Vibhors-Tech-Hub/STM32F407-Dev-Kit/production/BOM.csv

Reference Designators (RefDes) | Footprint | Description | Manufacturer Part Number (MPN) | Quantity (per PCB) | Quantity (including spares) | Price (in given quantity)
C1, C3, C4, C5, C6, C14, C18, C22, C23, C24, C26, C28, C29, C30, C34, C35, C38, C40, C41, C43, C45, C50, C55, C56, C57, C58, C60, C62, C63, C65, C67, C68, C69, C73, C76, C80, C81, C84, C85 | 0805 | 100n | 885012207016 | 39 | 43 | $1.80
C2, C54 | 0805 | 4.7u | CL21A475KPFNNNF | 2 | 5 | $0.55
C7, C15, C19, C31, C32, C33 | 0805 | 10n | 885012207011 | 6 | 9 | $0.59
C8, C13, C17, C25, C37, C39, C42, C44, C47, C52, C64, C66 | 0805 | 1u | CL21B105KPFNNNG | 12 | 15 | $0.83
C9, C10, C20, C21, C70, C71 | 0805 | 22p | 885012007002 | 6 | 8 | $0.57
C11 | 0805 | 2n | C0805C202G8HACTU | 1 | 2 | $0.42
C12, C16, C36, C46, C72, C82, C86 | 0805 | 10u | GRM21BR71A106KA73K | 7 | 9 | $0.70
C27, C75 | 1210 | 100u | EMK325ABJ107MM-P | 2 | 3 | $6.53
C48, C49 | 0805 | 150p | 885012007058 | 2 | 3 | $0.33
C51, C53 | 0805 | 22n | CL21B223JBANNNC | 2 | 3 | $0.30
C59, C61 | 0805 | 2.2u | 0805B225K250CT | 2 | 3 | $0.39
C74 | 10*12.5 | 1000u | A768MS108M1CLAE015 | 1 | 2 | $2.34
C77, C79 | 0805 | 22u | CL21A226KQCLRNC | 2 | 3 | $0.51
C78 | 0805 | 47u | GRM21BR60J476ME01L | 1 | 2 | $0.60
C83 | 1812 | 10n 2kV | C1812X103K202T | 1 | 2 | $2.14
D1, D2 | 0805 | RED | LS R976-NR-1-0-20-R18 | 2 | 3 | $0.54
D3, D4, D5, D6 | D_SOD-923 | ESD3V3D9-TP | ESD3V3D9-TP | 4 | 6 | $1.98
FB1 | 0603 | MPZ1608S331A | MPZ1608S331A | 1 | 2 | $0.20
FB2, FB3, FB4 | 0805 | BLM21PG102SN1D | BLM21PG102SN1D | 3 | 5 | $0.90
J1, J8 | USB_Mini-B_Wuerth_65100516121_Horizontal | GMSB0531112YEU | GMSB0531112YEU | 2 | 5 | $2.86
J2 | PinHeader_1x06_P2.54mm_Vertical | Conn_01x06 |  | 1 | 0 | $0
J3 | RJMG1S8008101BR | RJMG1S8008101BR | RJMG1S8008101BR | 1 | 1 | $2.00
J4 | JST_XH_B2B-XH-A_1x02_P2.50mm_Vertical | B2B-XH-A(LF)(SN) | B2B-XH-A(LF)(SN) | 1 | 2 | $19.02
J5, J9, J10 | PinHeader_1x04_P2.54mm_Vertical | Conn_01x04 |  | 3 | 0 | $0
J7 | SJ-3524-SMT | SJ-3524-SMT | SJ-3524-SMT | 1 | 3 | $3.07
J11 | TBC 2.54mm | TBC 2.54mm 10A | 397730003 | 1 | 2 | $7.11
J12 | IMP34DT05TR | IMP34DT05TR | IMP34DT05TR | 1 | 5 | $16.78
L1 | 0805 | 4.7u | AOTA-N201210S-4R7MT | 1 | 2 | $0.60
R1, R7, R8, R9, R10, R14, R15, R23 | 0805 | 10k | RNCP0805FTD10K0 | 8 | 10 | $0.14
R2 | 0805 | 100r | RC0805FR-07100RL | 1 | 2 | $0.20
R3 | 0805 | 1.5k | RC0805FR-071K5L | 1 | 2 | $0.20
R4 | 0805 | 6.49k 1% | RK73H2ATTD6491F | 1 | 2 | $19.02
R5, R6, R12 | 0805 | 3.3k | RC0805FR-073K3L | 3 | 5 | $0.34
R11, R24, R25 | 0805 | 2k | RK73H2ATTD2001F | 3 | 4 | $0.34
R13 | 0805 | 33k | ERJ-6GEYJ333V | 1 | 2 | $0.20
R16 | 0805 | 50m | RL1220T-R050-G | 1 | 2 | $0.20
R17 | 0805 | 10k | RK73H2ATTD1002F | 1 | 2 | $0.20
R18, R19, R20 | 0805 | 1K | CRCW08051K00FKEA | 3 | 5 | $0.44
R21, R22 | 0805 | 51.1R | RMCF0805FT51R1 | 2 | 3 | $0.27
R26 | 0805 | 1M | SG73P2ATTD1004F | 1 | 2 | $0.30
SW1, SW2, SW3 | SW Push SPST NO Alps SKRK | SW TACT-SPST | SKRKAEE020 | 3 | 4 | $1.64
U1 | LQFP-48_7x7mm_P0.5mm | STM32F103CBT6 | STM32F103CBT6 | 1 | 2 | $21.19
U2 | DP83826IRHBR | DP83826IRHBR | DP83826IRHBR | 1 | 7 | $23.29
U3 | QFN-24-1EP_4x4mm_P0.5mm_EP2.7x2.7mm | DRV8701ERGET | DRV8701ERGET | 1 | 7 | $20.55
U4 | V-DFN5045-12 | DMHT6016LFJ-13 | DMHT6016LFJ-13 | 1 | 3 | $6.28
U5 | TSSOP-16_4.4x5mm_P0.65mm | ADS122C04IPW | ADS122C04IPW | 1 | 2 | $25.41
U6 | VQFN-40-1EP_6x6mm_P0.5mm_EP3.5x3.5mm | CS43L22 | CS43L22 | 1 | 0 | $0
U7 | LQFP-100_14x14mm_P0.5mm | STM32F407VGT6 | STM32F407VGT6 | 1 | 2 | $33.27
U8 | TSOT-23-6 | AP63203WU | AP63203WU | 1 | 3 | $350.97
U9 | SOT-23-3 | XC6206P182MR | XC6206P182MR | 1 | 3 | $28.53
Y1, Y3 | 3225 | ABM8G-8.000MHZ-18-D2Y-T | ECS-80-12-33-JGN-TR3 | 2 | 4 | $2.45
Y2 | 3225 | ABM8G-25.000MHZ-9-B4Y-T | ABM8G-25.000MHZ-9-B4Y-T | 1 | 3 | $2.13
Total: |  |  |  |  |  | $198.13
