Vibhors-Tech-Hub/STM32F407-Dev-Kit/3D/STM32F407 Dev Kit.step

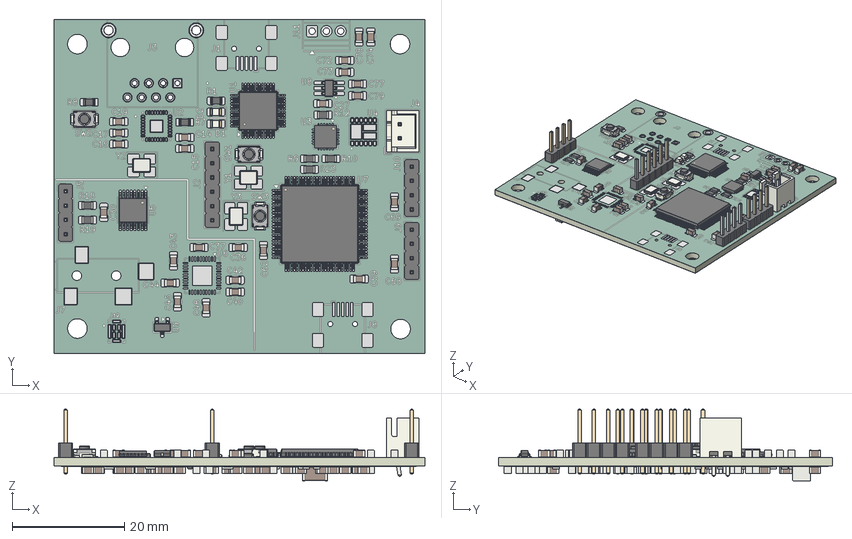
[picture p1: CAD file, 2026-10-30]
3D/STM32F407 Dev Kit.step
66.0 x 59.3 x 12.7 mm
C_0805_2012Metric x 88
LQFP-100_14x14mm_P0.5mm
R_0805_2012Metric x 26
LQFP-48_7x7mm_P0.5mm
JST_B2B_XH_A
SW_Push_SPST_NO_Alps_SKRK x 3
Crystal_SMD_3225-4Pin_3.2x2.5mm x 3
QFN-24-1EP_4x4mm_P0.5mm_EP2.7x2.7mm
PinHeader_1x04_P254mm_Vertical x 3
LED_0805_2012Metric x 2
PinHeader_1x06_P254mm_Vertical
TSOT-23-6
SOT-23-3
TSSOP-16_4.4x5mm_P0.65mm
C_0603_1608Metric
C_1812_4532Metric
D_SOD_923 x 4
L_0805_2012Metric
STM3A46_copper
STM3A46_pad
STM3A46_via
STM3A46_silkscreen x 2
STM3A46_soldermask x 2
STM3A46_PCB
