Vibhors-Tech-Hub/STM32F407-Dev-Kit/hardware/STM32F407 Dev Kit.kicad_pcb

## KiCad design hardware/STM32F407 Dev Kit.kicad_pcb (2026-11-01)

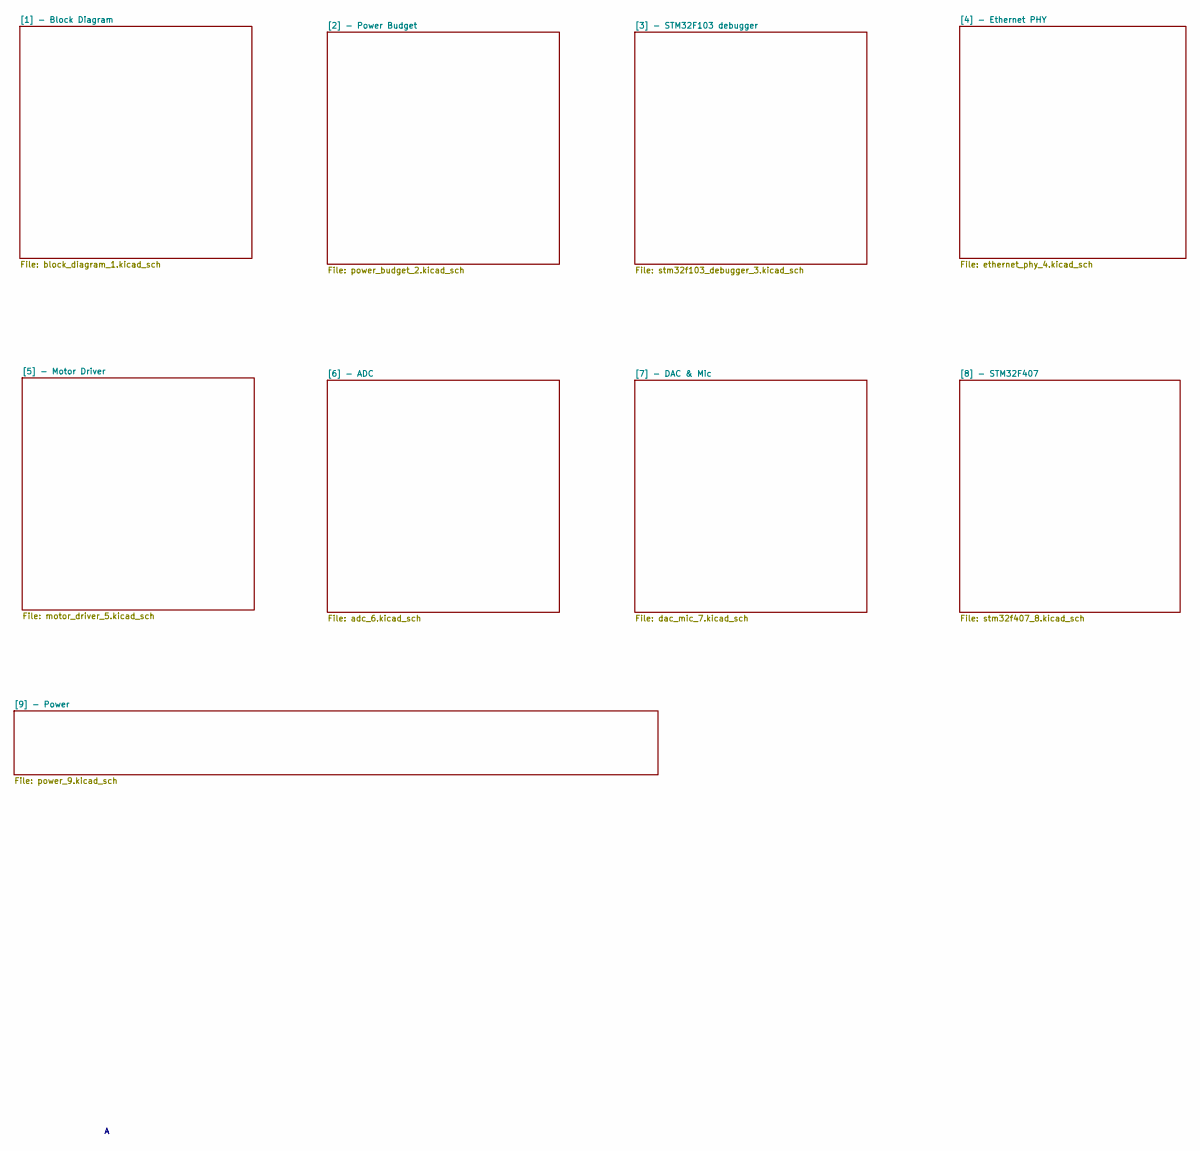
[picture p2: schematic STM32F407 Dev Kit.kicad_sch]

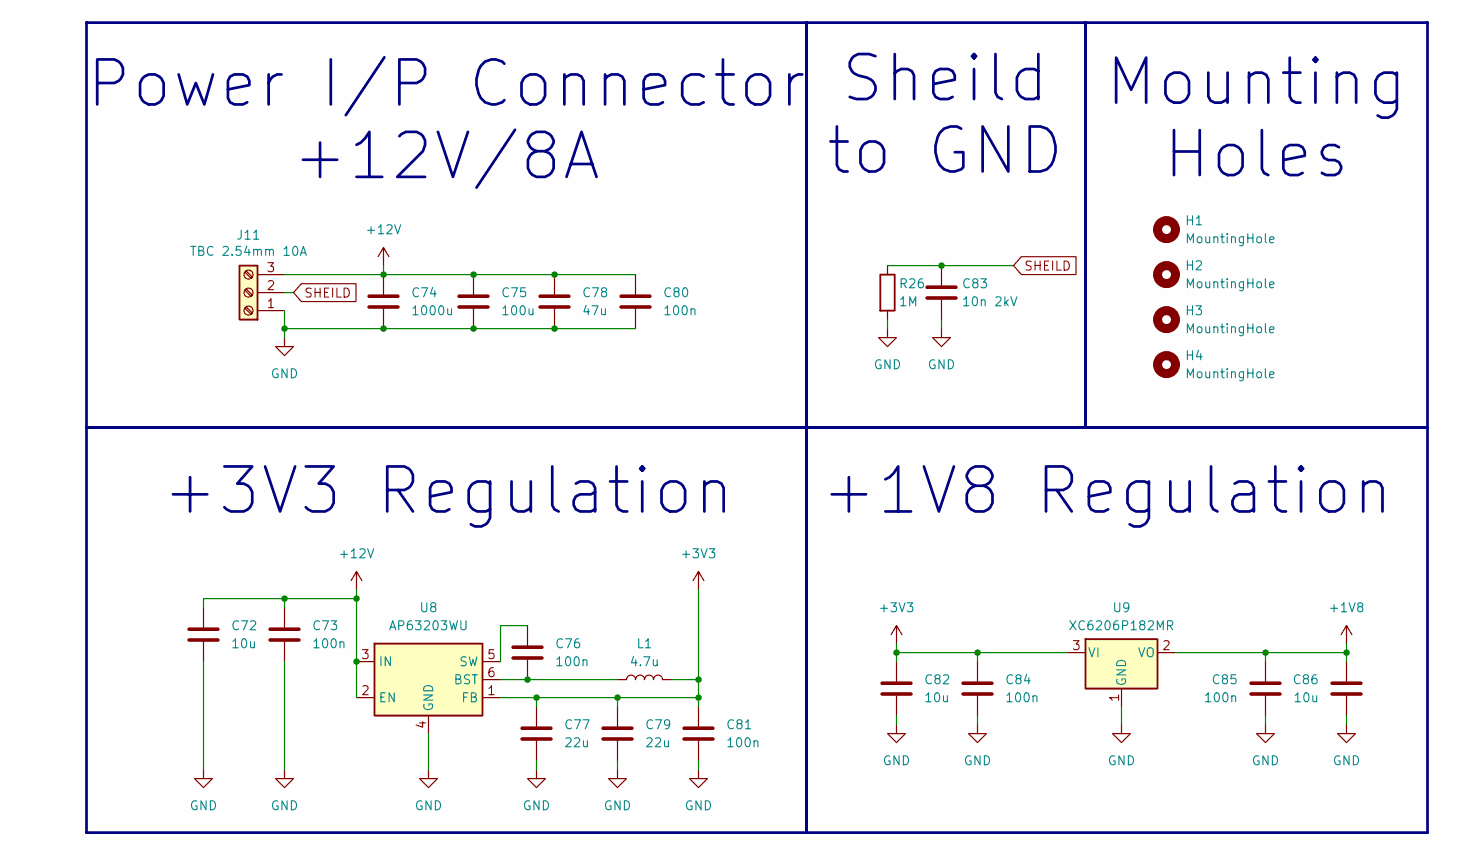
[picture p3: schematic power_9.kicad_sch]

Parts:
C72, C82, C86: 10u; C_0805_2012Metric_Pad1.18x1.45mm_HandSolder
C73, C76, C80, C81, C84, C85: 100n; C_0805_2012Metric_Pad1.18x1.45mm_HandSolder
C74: 1000u; CP_Elec_10x12.5
C75: 100u; C_1210_3225Metric_Pad1.33x2.70mm_HandSolder
C77, C79: 22u; C_0805_2012Metric_Pad1.18x1.45mm_HandSolder
C78: 47u; C_0805_2012Metric_Pad1.18x1.45mm_HandSolder
C83: 10n 2kV; C_1812_4532Metric_Pad1.57x3.40mm_HandSolder
H1, H2, H3, H4: MountingHole; MountingHole_3.5mm
J11: TBC 2.54mm 10A; TerminalBlock_Xinya_XY308-2.54-3P_1x03_P2.54mm_Horizontal
L1: 4.7u; L_0805_2012Metric_Pad1.05x1.20mm_HandSolder
R26: 1M; R_0805_2012Metric_Pad1.20x1.40mm_HandSolder
U8: AP63203WU; TSOT-23-6_HandSoldering
U9: XC6206P182MR; SOT-23-3

Connections:
+1V8: C85.1, C86.1, U9.2 (VO); also elsewhere on the board
+3V3: C77.1, C79.1, C81.1, C82.1, C84.1, L1.2, U8.1 (FB), U9.3 (VI); also elsewhere on the board
+12V: C72.1, C73.1, C74.1, C75.1, C78.1, C80.1, J11.3, U8.2 (EN), U8.3 (IN); also elsewhere on the board
GND: C72.2, C73.2, C74.2, C75.2, C77.2, C78.2, C79.2, C80.2, C81.2, C82.2, C83.2, C84.2, C85.2, C86.2, J11.1, R26.2, U8.4 (GND), U9.1 (GND); also elsewhere on the board
unnamed: C76.2, L1.1, U8.6 (BST)
unnamed: C76.1, U8.5 (SW)
SHEILD: C83.1, J11.2, R26.1; also elsewhere on the board

Notes on the sheet:
+3V3 Regulation
Sheild to GND
Power I/P Connector +12V/8A
Mounting Holes
+1V8 Regulation

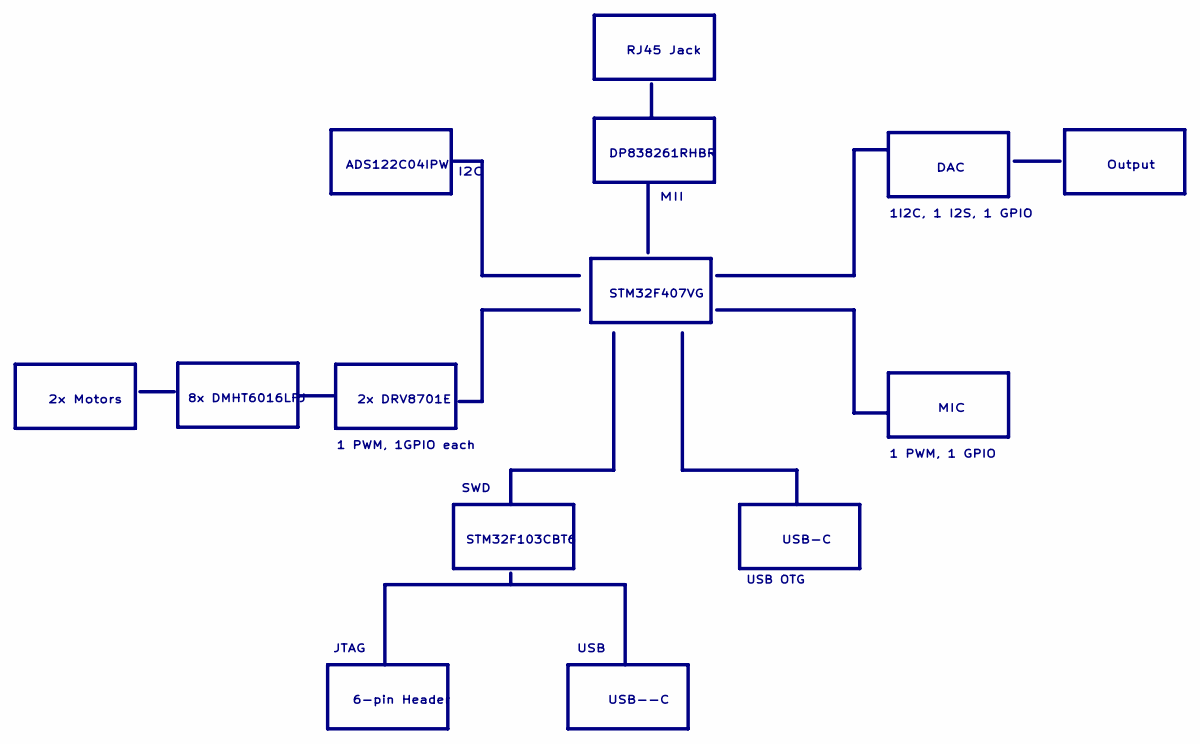
[picture p4: schematic block_diagram_1.kicad_sch]

Notes on the sheet:
6-pin Header
JTAG
DP838261RHBR
ADS122C04IPW
USB--C
2x Motors
USB-C
STM32F103CBT6
1 PWM, 1GPIO each
8x DMHT6016LFJ
STM32F407VG
SWD
Output
MIC
DAC
2x DRV8701E
RJ45 Jack
I2C
1I2C, 1 I2S, 1 GPIO
1 PWM, 1 GPIO
MII
USB
USB OTG

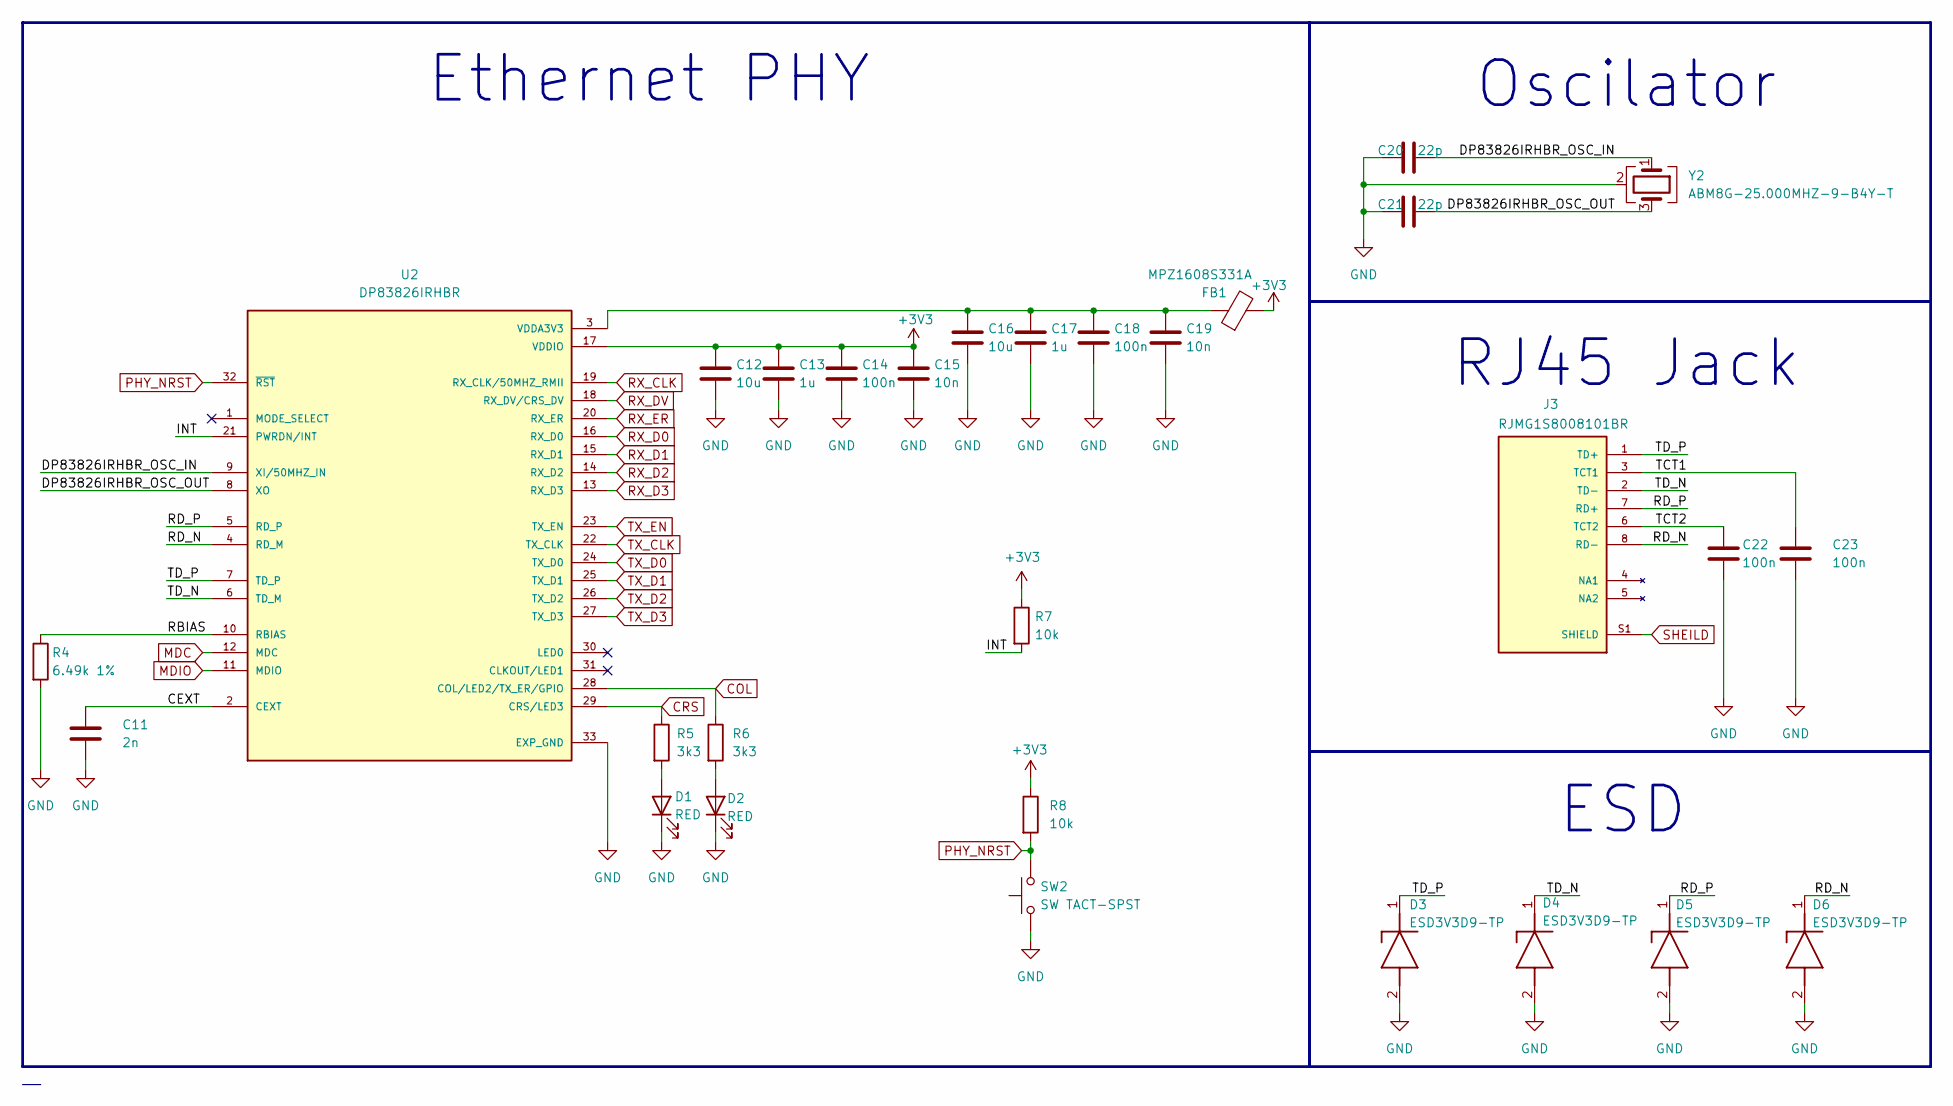
[picture p5: schematic ethernet_phy_4.kicad_sch]

Parts:
C11: 2n; C_0805_2012Metric_Pad1.18x1.45mm_HandSolder
C12, C16: 10u; C_0805_2012Metric_Pad1.18x1.45mm_HandSolder
C13, C17: 1u; C_0805_2012Metric_Pad1.18x1.45mm_HandSolder
C14, C18, C22, C23: 100n; C_0805_2012Metric_Pad1.18x1.45mm_HandSolder
C15, C19: 10n; C_0805_2012Metric_Pad1.18x1.45mm_HandSolder
C20, C21: 22p; C_0805_2012Metric_Pad1.18x1.45mm_HandSolder
D1, D2: RED; LED_0805_2012Metric_Pad1.15x1.40mm_HandSolder
D3, D4, D5, D6: ESD3V3D9-TP; D_SOD-923; Manufacturer_Part_Number ESD3V3D9-TP; Mouser Part Number 833-ESD3V3D9-TP
FB1: MPZ1608S331A; C_0603_1608Metric_Pad1.08x0.95mm_HandSolder
J3: RJMG1S8008101BR; PARTREV A
R4: 6.49k 1%; R_0805_2012Metric_Pad1.20x1.40mm_HandSolder
R5, R6: 3k3; R_0805_2012Metric_Pad1.20x1.40mm_HandSolder
R7, R8: 10k; R_0805_2012Metric_Pad1.20x1.40mm_HandSolder
SW2: SW TACT-SPST; SW_Push_SPST_NO_Alps_SKRK
U2: DP83826IRHBR; PARTREV G
Y2: ABM8G-25.000MHZ-9-B4Y-T; Crystal_SMD_3225-4Pin_3.2x2.5mm_HandSoldering

Connections:
+3V3: C12.1, C13.1, C14.1, C15.1, FB1.2, R7.1, R8.1, U2.17 (VDDIO); also elsewhere on the board
/[4] - Ethernet PHY/CEXT: C11.1, U2.2 (CEXT)
/[4] - Ethernet PHY/DP83826IRHBR_OSC_IN: C20.2, U2.9 (XI/50MHZ_IN), Y2.1
/[4] - Ethernet PHY/DP83826IRHBR_OSC_OUT: C21.2, U2.8 (XO), Y2.3
/[4] - Ethernet PHY/INT: R7.2, U2.21 (PWRDN/INT)
/[4] - Ethernet PHY/RBIAS: R4.1, U2.10 (RBIAS)
/[4] - Ethernet PHY/RD_N: D6.1 (K), J3.8 (RD-), U2.4 (RD_M)
/[4] - Ethernet PHY/RD_P: D5.1 (K), J3.7 (RD+), U2.5 (RD_P)
/[4] - Ethernet PHY/TCT1: C23.1, J3.3 (TCT1)
/[4] - Ethernet PHY/TCT2: C22.1, J3.6 (TCT2)
/[4] - Ethernet PHY/TD_N: D4.1 (K), J3.2 (TD-), U2.6 (TD_M)
/[4] - Ethernet PHY/TD_P: D3.1 (K), J3.1 (TD+), U2.7 (TD_P)
COL: R6.1, U2.28 (COL/LED2/TX_ER/GPIO); also elsewhere on the board
CRS: R5.1, U2.29 (CRS/LED3); also elsewhere on the board
GND: C11.2, C12.2, C13.2, C14.2, C15.2, C16.2, C17.2, C18.2, C19.2, C20.1, C21.1, C22.2, C23.2, D1.1 (K), D2.1 (K), D3.2 (A), D4.2 (A), D5.2 (A), D6.2 (A), R4.2, SW2.1, U2.33 (EXP_GND), Y2.2 (G), Y2.4 (G); also elsewhere on the board
MDC: U2.12 (MDC); also elsewhere on the board
MDIO: U2.11 (MDIO); also elsewhere on the board
unnamed: D1.2 (A), R5.2
unnamed: D2.2 (A), R6.2
unnamed: C16.1, C17.1, C18.1, C19.1, FB1.1, U2.3 (VDDA3V3)
PHY_NRST: R8.2, SW2.2, U2.32 (~RST); also elsewhere on the board
RX_CLK: U2.19 (RX_CLK/50MHZ_RMII); also elsewhere on the board
RX_D0: U2.16 (RX_D0); also elsewhere on the board
RX_D1: U2.15 (RX_D1); also elsewhere on the board
RX_D2: U2.14 (RX_D2); also elsewhere on the board
RX_D3: U2.13 (RX_D3); also elsewhere on the board
RX_DV: U2.18 (RX_DV/CRS_DV); also elsewhere on the board
RX_ER: U2.20 (RX_ER); also elsewhere on the board
SHEILD: J3.S1 (SHIELD), J3.S2 (SHIELD); also elsewhere on the board
TX_CLK: U2.22 (TX_CLK); also elsewhere on the board
TX_D0: U2.24 (TX_D0); also elsewhere on the board
TX_D1: U2.25 (TX_D1); also elsewhere on the board
TX_D2: U2.26 (TX_D2); also elsewhere on the board
TX_D3: U2.27 (TX_D3); also elsewhere on the board
TX_EN: U2.23 (TX_EN); also elsewhere on the board

Notes on the sheet:
ESD
RJ45 Jack
Ethernet PHY
Oscilator

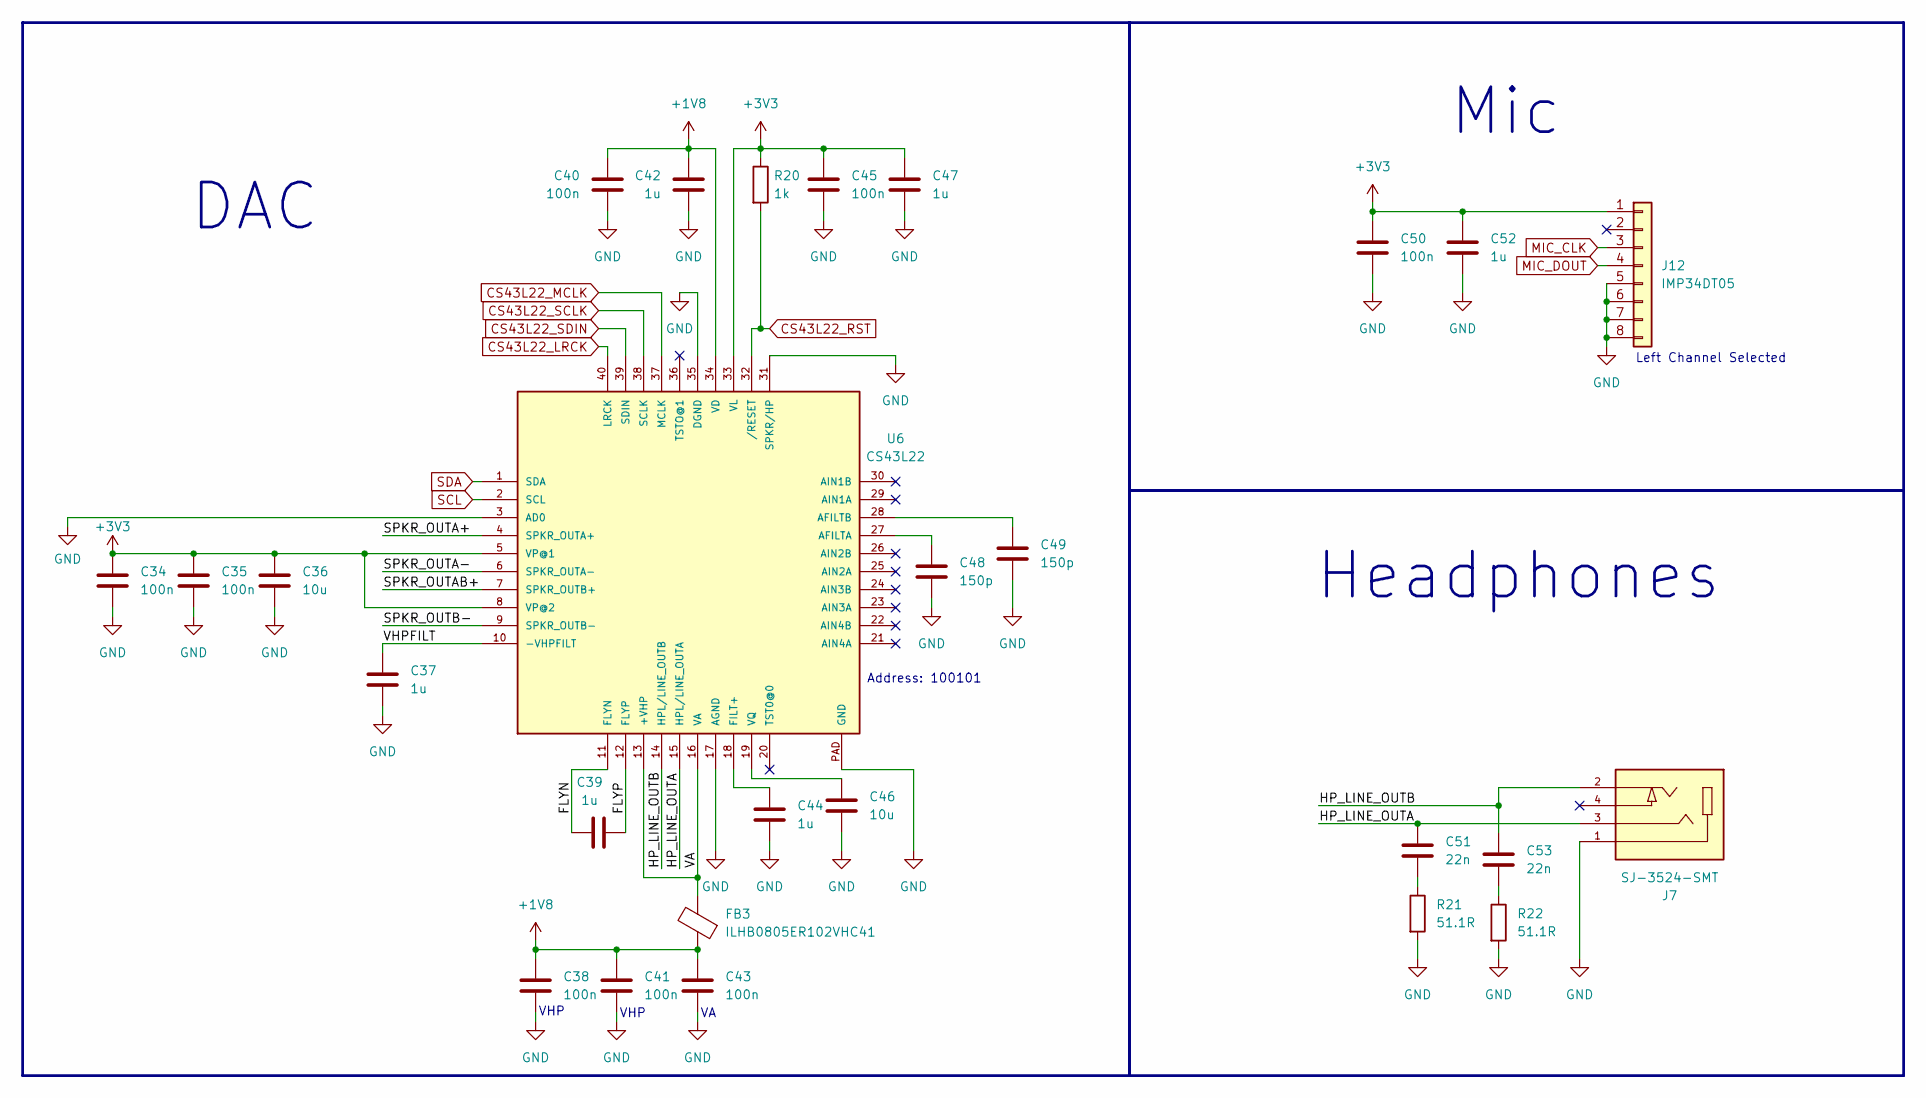
[picture p6: schematic dac_mic_7.kicad_sch]

Parts:
C34, C35, C38, C40, C41, C43, C45, C50: 100n; C_0805_2012Metric_Pad1.18x1.45mm_HandSolder
C36, C46: 10u; C_0805_2012Metric_Pad1.18x1.45mm_HandSolder
C37, C39, C42, C44, C47, C52: 1u; C_0805_2012Metric_Pad1.18x1.45mm_HandSolder
C48, C49: 150p; C_0805_2012Metric_Pad1.18x1.45mm_HandSolder
C51, C53: 22n; C_0805_2012Metric_Pad1.18x1.45mm_HandSolder
FB3: ILHB0805ER102VHC41; C_0805_2012Metric_Pad1.18x1.45mm_HandSolder
J7: SJ-3524-SMT; PARTREV 1.03
J12: IMP34DT05; IMP34DT06JTR
R20: 1k; R_0805_2012Metric_Pad1.20x1.40mm_HandSolder
R21, R22: 51.1R; R_0805_2012Metric_Pad1.20x1.40mm_HandSolder
U6: CS43L22; VQFN-40-1EP_6x6mm_P0.5mm_EP3.5x3.5mm

Connections:
+1V8: C38.2, C40.1, C41.2, C42.1, C43.2, FB3.1, U6.34 (VD); also elsewhere on the board
+3V3: C34.1, C35.1, C36.1, C45.1, C47.1, C50.1, C52.1, J12.1, R20.1, U6.5 (VP@1), U6.8 (VP@2), U6.33 (VL); also elsewhere on the board
/[7] - DAC & Mic/FLYN: C39.1, U6.11 (FLYN)
/[7] - DAC & Mic/FLYP: C39.2, U6.12 (FLYP)
/[7] - DAC & Mic/HP_LINE_OUTA: C51.2, J7.3, U6.15 (HPL/LINE_OUTA)
/[7] - DAC & Mic/HP_LINE_OUTB: C53.2, J7.2, U6.14 (HPL/LINE_OUTB)
/[7] - DAC & Mic/SPKR_OUTA+: U6.4 (SPKR_OUTA+)
/[7] - DAC & Mic/SPKR_OUTA-: U6.6 (SPKR_OUTA-)
/[7] - DAC & Mic/SPKR_OUTAB+: U6.7 (SPKR_OUTB+)
/[7] - DAC & Mic/SPKR_OUTB-: U6.9 (SPKR_OUTB-)
/[7] - DAC & Mic/VA: FB3.2, U6.13 (+VHP), U6.16 (VA)
/[7] - DAC & Mic/VHPFILT: C37.2, U6.10 (-VHPFILT)
CS43L22_LRCK: U6.40 (LRCK); also elsewhere on the board
CS43L22_MCLK: U6.37 (MCLK); also elsewhere on the board
CS43L22_RST: R20.2, U6.32 (/RESET); also elsewhere on the board
CS43L22_SCLK: U6.38 (SCLK); also elsewhere on the board
CS43L22_SDIN: U6.39 (SDIN); also elsewhere on the board
GND: C34.2, C35.2, C36.2, C37.1, C38.1, C40.2, C41.1, C42.2, C43.1, C44.2, C45.2, C46.2, C47.2, C48.2, C49.2, C50.2, C52.2, J7.1, J12.5, J12.6, J12.7, J12.8, R21.2, R22.2, U6.3 (AD0), U6.17 (AGND), U6.31 (SPKR/HP), U6.35 (DGND), U6.PAD (GND); also elsewhere on the board
MIC_CLK: J12.3; also elsewhere on the board
MIC_DOUT: J12.4; also elsewhere on the board
unnamed: C51.1, R21.1
unnamed: C53.1, R22.1
unnamed: C48.1, U6.27 (AFILTA)
unnamed: C49.1, U6.28 (AFILTB)
unnamed: C44.1, U6.18 (FILT+)
unnamed: C46.1, U6.19 (VQ)
SCL: U6.2 (SCL); also elsewhere on the board
SDA: U6.1 (SDA); also elsewhere on the board

Notes on the sheet:
Headphones
VHP
DAC
Address: 100101
Left Channel Selected
Mic

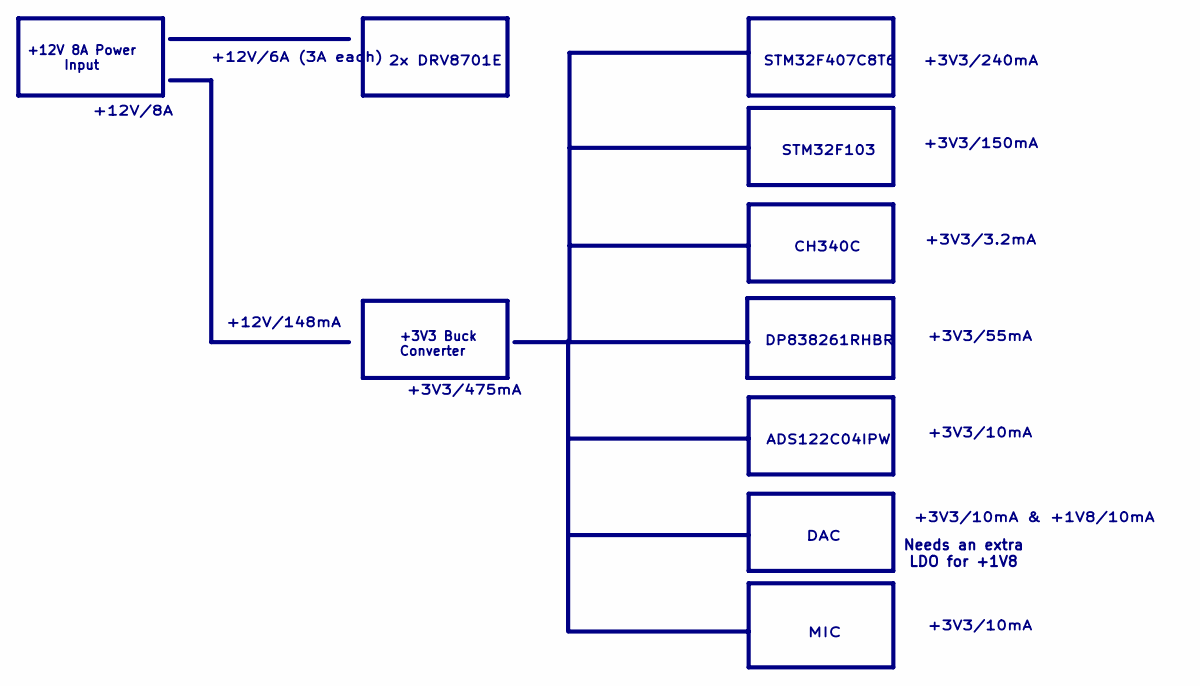
[picture p7: schematic power_budget_2.kicad_sch]

Notes on the sheet:
+3V3/3.2mA
DP838261RHBR
CH340C
Needs an extra LDO for +1V8
+3V3 Buck Converter
ADS122C04IPW
2x DRV8701E
+3V3/10mA
+3V3/475mA
STM32F103
+3V3/150mA
+12V/6A (3A each)
+3V3/55mA
DAC
+12V/148mA
MIC
STM32F407C8T6
+12V/8A
+3V3/240mA
+3V3/10mA & +1V8/10mA
+12V 8A Power Input

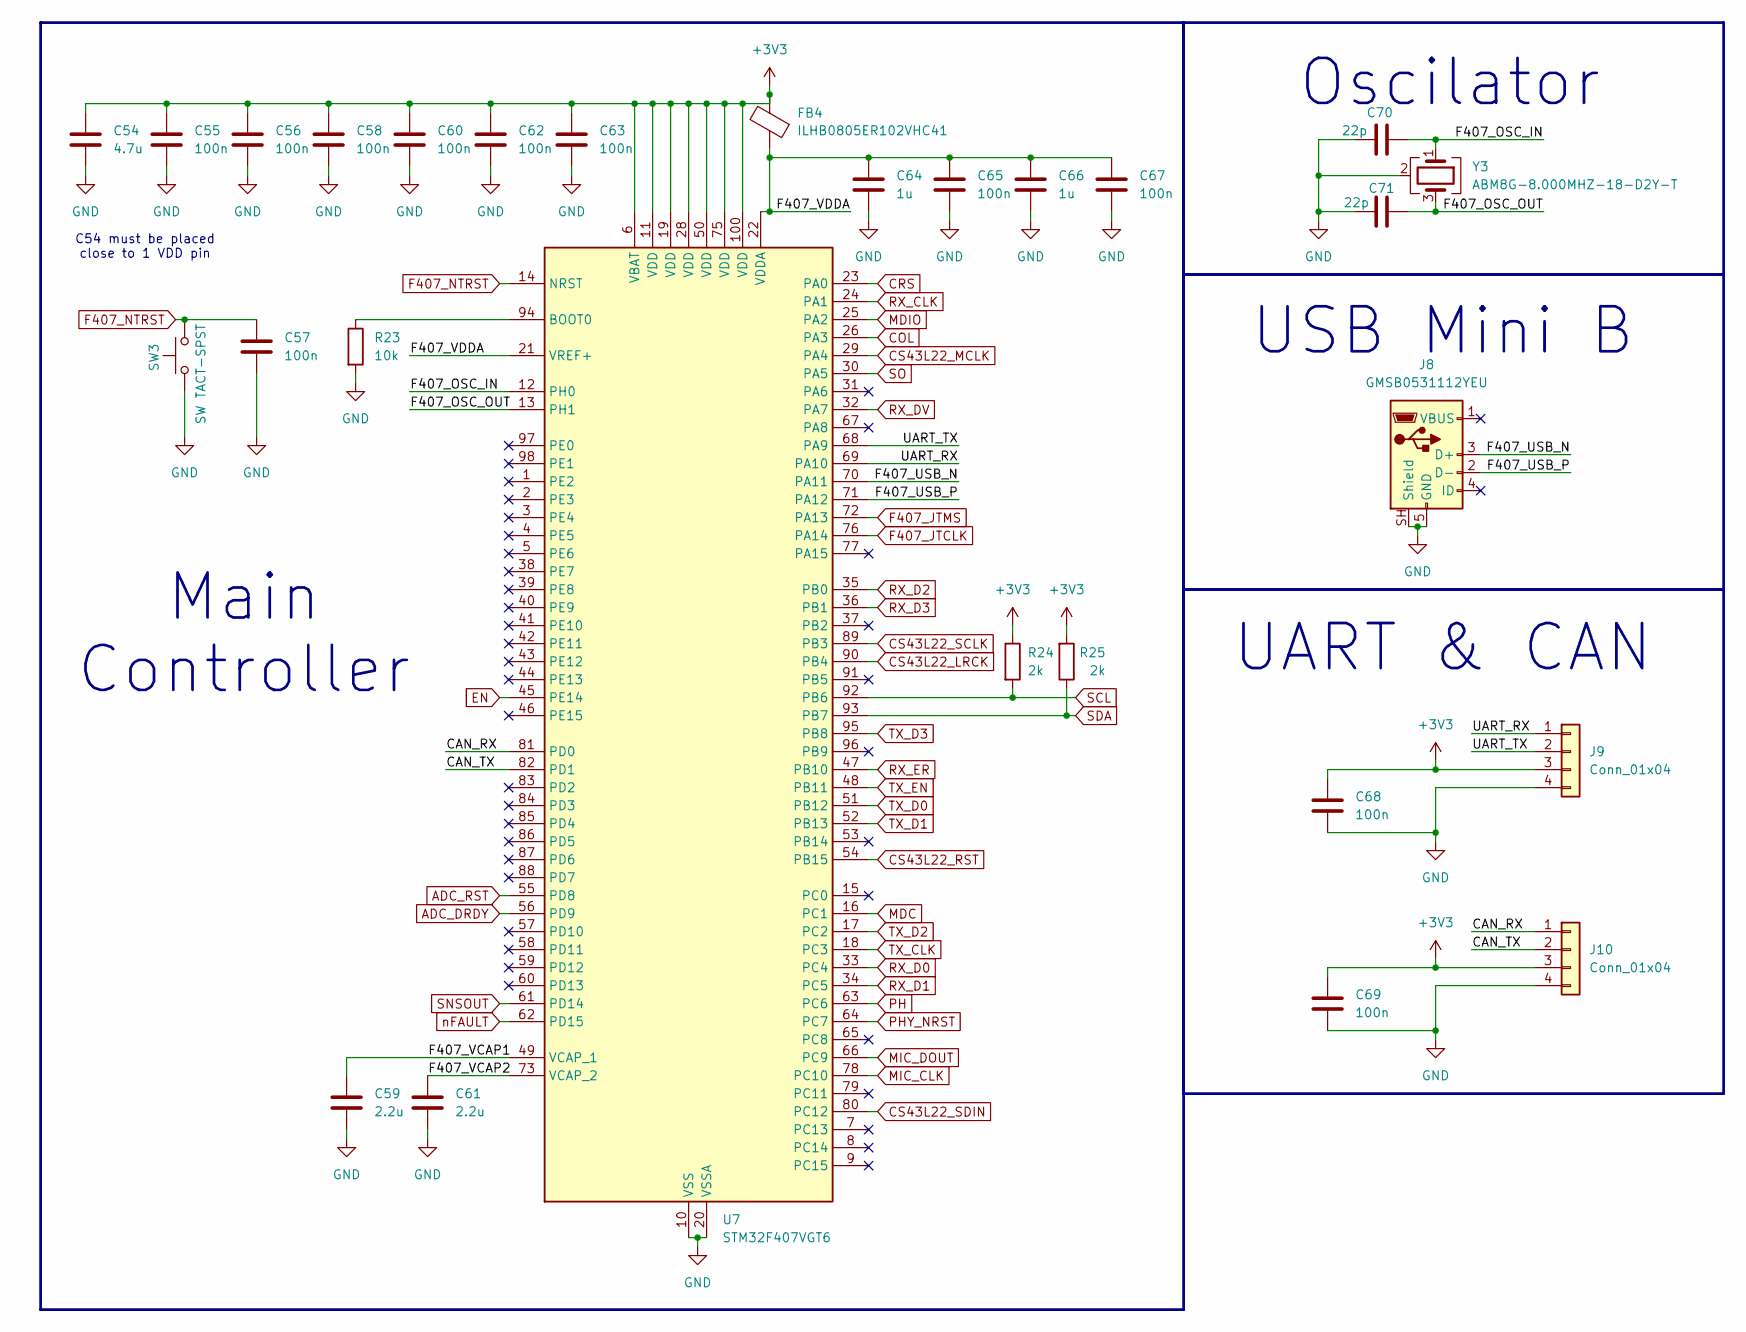
[picture p8: schematic stm32f407_8.kicad_sch]

Parts:
C54: 4.7u; C_0805_2012Metric_Pad1.18x1.45mm_HandSolder
C55, C56, C57, C58, C60, C62, C63, C65, C67, C68, C69: 100n; C_0805_2012Metric_Pad1.18x1.45mm_HandSolder
C59, C61: 2.2u; C_0805_2012Metric_Pad1.18x1.45mm_HandSolder
C64, C66: 1u; C_0805_2012Metric_Pad1.18x1.45mm_HandSolder
C70, C71: 22p; C_0805_2012Metric_Pad1.18x1.45mm_HandSolder
FB4: ILHB0805ER102VHC41; C_0805_2012Metric_Pad1.18x1.45mm_HandSolder
J8: GMSB0531112YEU; USB_Mini-B_Wuerth_65100516121_Horizontal
J9, J10: Conn_01x04; PinHeader_1x04_P2.54mm_Vertical
R23: 10k; R_0805_2012Metric_Pad1.20x1.40mm_HandSolder
R24, R25: 2k; R_0805_2012Metric_Pad1.20x1.40mm_HandSolder
SW3: SW TACT-SPST; SW_Push_SPST_NO_Alps_SKRK
U7: STM32F407VGT6; LQFP-100_14x14mm_P0.5mm
Y3: ABM8G-8.000MHZ-18-D2Y-T; Crystal_SMD_3225-4Pin_3.2x2.5mm_HandSoldering

Connections:
+3V3: C54.1, C55.1, C56.1, C58.1, C60.1, C62.1, C63.1, C68.1, C69.1, FB4.2, J9.3, J10.3, R24.1, R25.2, U7.6 (VBAT), U7.11 (VDD), U7.19 (VDD), U7.28 (VDD), U7.50 (VDD), U7.75 (VDD), U7.100 (VDD); also elsewhere on the board
/[8] - STM32F407/CAN_RX: J10.1, U7.81 (PD0)
/[8] - STM32F407/CAN_TX: J10.2, U7.82 (PD1)
/[8] - STM32F407/F407_OSC_IN: C70.2, U7.12 (PH0), Y3.1
/[8] - STM32F407/F407_OSC_OUT: C71.2, U7.13 (PH1), Y3.3
/[8] - STM32F407/F407_USB_N: J8.3 (D+), U7.70 (PA11)
/[8] - STM32F407/F407_USB_P: J8.2 (D-), U7.71 (PA12)
/[8] - STM32F407/F407_VCAP1: C59.1, U7.49 (VCAP_1)
/[8] - STM32F407/F407_VCAP2: C61.1, U7.73 (VCAP_2)
/[8] - STM32F407/F407_VDDA: C64.1, C65.1, C66.1, C67.1, FB4.1, U7.21 (VREF+), U7.22 (VDDA)
/[8] - STM32F407/UART_RX: J9.1, U7.69 (PA10)
/[8] - STM32F407/UART_TX: J9.2, U7.68 (PA9)
ADC_DRDY: U7.56 (PD9); also elsewhere on the board
ADC_RST: U7.55 (PD8); also elsewhere on the board
COL: U7.26 (PA3); also elsewhere on the board
CRS: U7.23 (PA0); also elsewhere on the board
CS43L22_LRCK: U7.90 (PB4); also elsewhere on the board
CS43L22_MCLK: U7.29 (PA4); also elsewhere on the board
CS43L22_RST: U7.54 (PB15); also elsewhere on the board
CS43L22_SCLK: U7.89 (PB3); also elsewhere on the board
CS43L22_SDIN: U7.80 (PC12); also elsewhere on the board
EN: U7.45 (PE14); also elsewhere on the board
F407_JTCLK: U7.76 (PA14); also elsewhere on the board
F407_JTMS: U7.72 (PA13); also elsewhere on the board
F407_NTRST: C57.1, SW3.2, U7.14 (NRST); also elsewhere on the board
GND: C54.2, C55.2, C56.2, C57.2, C58.2, C59.2, C60.2, C61.2, C62.2, C63.2, C64.2, C65.2, C66.2, C67.2, C68.2, C69.2, C70.1, C71.1, J8.5 (GND), J8.SH (Shield), J9.4, J10.4, R23.2, SW3.1, U7.10 (VSS), U7.20 (VSSA), U7.27 (VSS), U7.74 (VSS), U7.99 (VSS), Y3.2 (G), Y3.4 (G); also elsewhere on the board
MDC: U7.16 (PC1); also elsewhere on the board
MDIO: U7.25 (PA2); also elsewhere on the board
MIC_CLK: U7.78 (PC10); also elsewhere on the board
MIC_DOUT: U7.66 (PC9); also elsewhere on the board
unnamed: R23.1, U7.94 (BOOT0)
PH: U7.63 (PC6); also elsewhere on the board
PHY_NRST: U7.64 (PC7); also elsewhere on the board
RX_CLK: U7.24 (PA1); also elsewhere on the board
RX_D0: U7.33 (PC4); also elsewhere on the board
RX_D1: U7.34 (PC5); also elsewhere on the board
RX_D2: U7.35 (PB0); also elsewhere on the board
RX_D3: U7.36 (PB1); also elsewhere on the board
RX_DV: U7.32 (PA7); also elsewhere on the board
RX_ER: U7.47 (PB10); also elsewhere on the board
SCL: R24.2, U7.92 (PB6); also elsewhere on the board
SDA: R25.1, U7.93 (PB7); also elsewhere on the board
SNSOUT: U7.61 (PD14); also elsewhere on the board
SO: U7.30 (PA5); also elsewhere on the board
TX_CLK: U7.18 (PC3); also elsewhere on the board
TX_D0: U7.51 (PB12); also elsewhere on the board
TX_D1: U7.52 (PB13); also elsewhere on the board
TX_D2: U7.17 (PC2); also elsewhere on the board
TX_D3: U7.95 (PB8); also elsewhere on the board
TX_EN: U7.48 (PB11); also elsewhere on the board
nFAULT: U7.62 (PD15); also elsewhere on the board

Notes on the sheet:
USB Mini B
Main Controller
Oscilator
UART & CAN
C54 must be placed close to 1 VDD pin

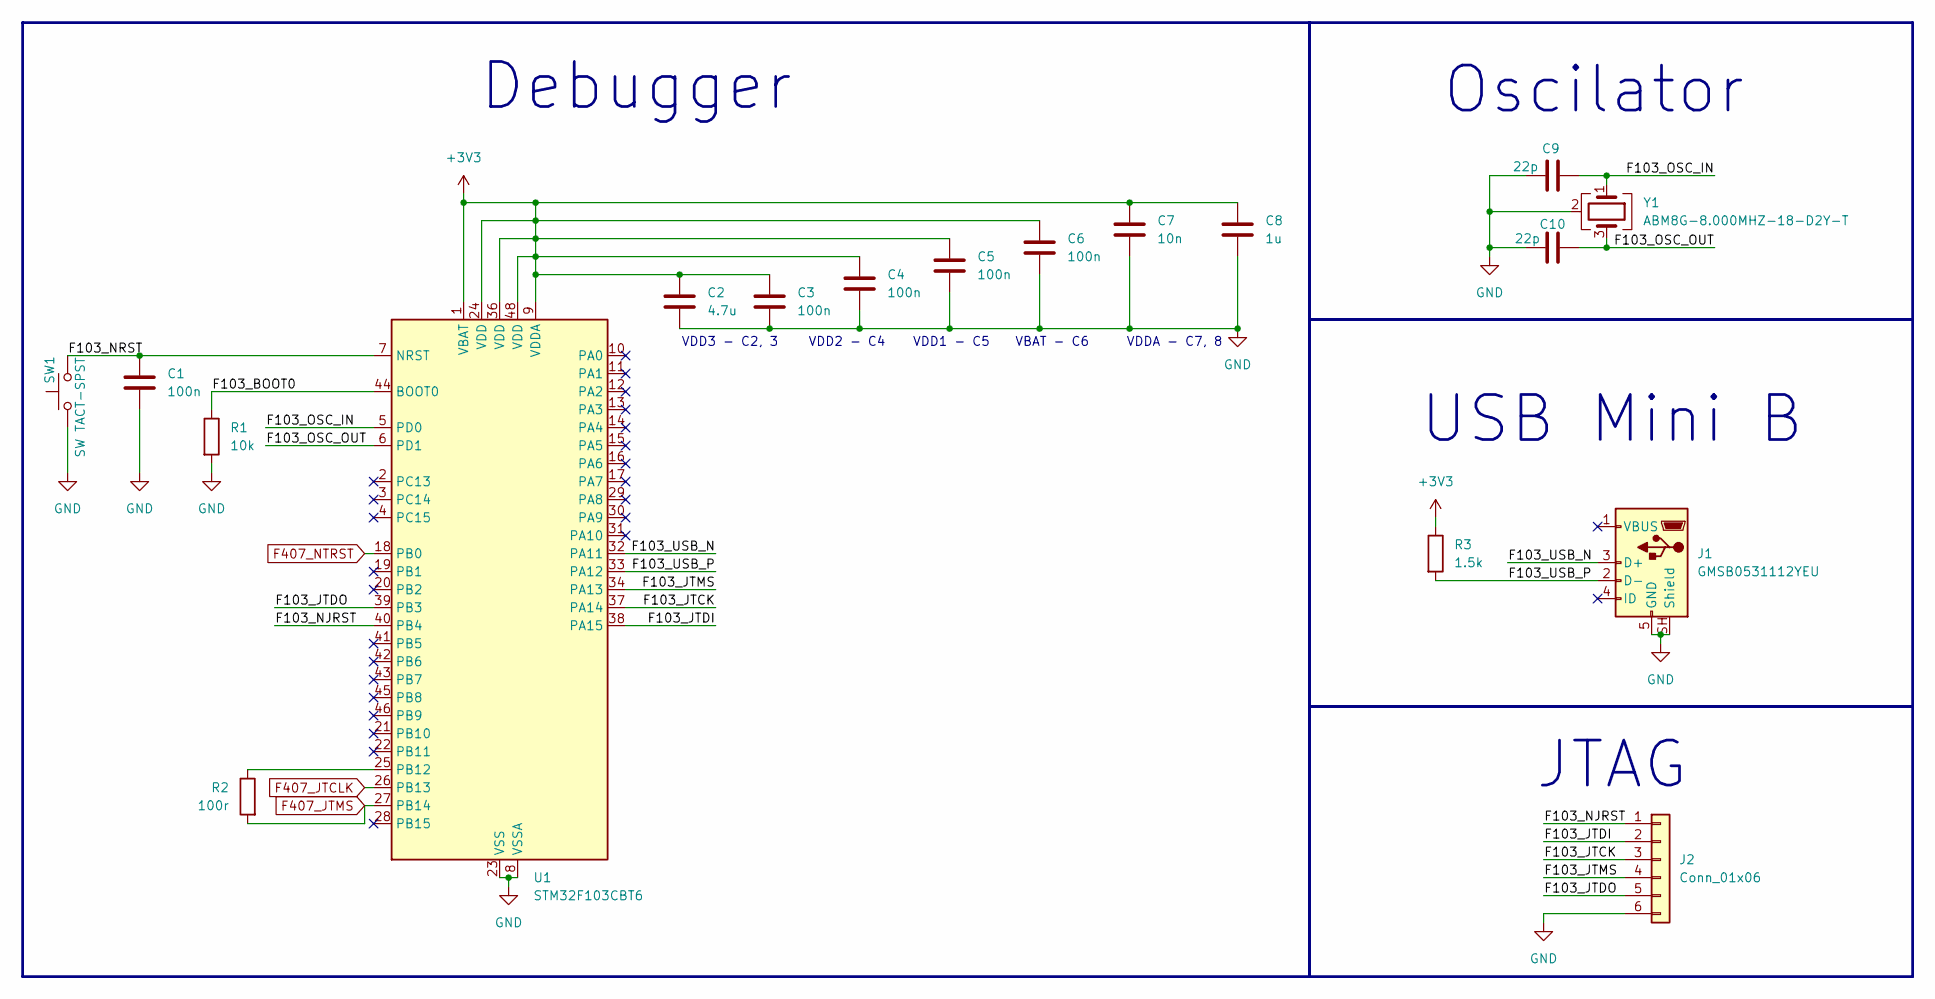
[picture p9: schematic stm32f103_debugger_3.kicad_sch]

Parts:
C1, C3, C4, C5, C6: 100n; C_0805_2012Metric_Pad1.18x1.45mm_HandSolder
C2: 4.7u; C_0805_2012Metric_Pad1.18x1.45mm_HandSolder
C7: 10n; C_0805_2012Metric_Pad1.18x1.45mm_HandSolder
C8: 1u; C_0805_2012Metric_Pad1.18x1.45mm_HandSolder
C9, C10: 22p; C_0805_2012Metric_Pad1.18x1.45mm_HandSolder
J1: GMSB0531112YEU; USB_Mini-B_Wuerth_65100516121_Horizontal
J2: Conn_01x06; PinHeader_1x06_P2.54mm_Vertical
R1: 10k; R_0805_2012Metric_Pad1.20x1.40mm_HandSolder
R2: 100r; R_0805_2012Metric_Pad1.20x1.40mm_HandSolder
R3: 1.5k; R_0805_2012Metric_Pad1.20x1.40mm_HandSolder
SW1: SW TACT-SPST; SW_Push_SPST_NO_Alps_SKRK
U1: STM32F103CBT6; LQFP-48_7x7mm_P0.5mm
Y1: ABM8G-8.000MHZ-18-D2Y-T; Crystal_SMD_3225-4Pin_3.2x2.5mm_HandSoldering

Connections:
+3V3: C2.1, C3.1, C4.1, C5.1, C6.1, C7.1, C8.1, R3.1, U1.1 (VBAT), U1.9 (VDDA), U1.24 (VDD), U1.36 (VDD), U1.48 (VDD); also elsewhere on the board
/[3] - STM32F103 debugger/F103_BOOT0: R1.1, U1.44 (BOOT0)
/[3] - STM32F103 debugger/F103_JTCK: J2.3, U1.37 (PA14)
/[3] - STM32F103 debugger/F103_JTDI: J2.2, U1.38 (PA15)
/[3] - STM32F103 debugger/F103_JTDO: J2.5, U1.39 (PB3)
/[3] - STM32F103 debugger/F103_JTMS: J2.4, U1.34 (PA13)
/[3] - STM32F103 debugger/F103_NJRST: J2.1, U1.40 (PB4)
/[3] - STM32F103 debugger/F103_NRST: C1.1, SW1.2, U1.7 (NRST)
/[3] - STM32F103 debugger/F103_OSC_IN: C9.2, U1.5 (PD0), Y1.1
/[3] - STM32F103 debugger/F103_OSC_OUT: C10.2, U1.6 (PD1), Y1.3
/[3] - STM32F103 debugger/F103_USB_N: J1.3 (D+), U1.32 (PA11)
/[3] - STM32F103 debugger/F103_USB_P: J1.2 (D-), R3.2, U1.33 (PA12)
F407_JTCLK: U1.26 (PB13); also elsewhere on the board
F407_JTMS: R2.2, U1.27 (PB14); also elsewhere on the board
F407_NTRST: U1.18 (PB0); also elsewhere on the board
GND: C1.2, C2.2, C3.2, C4.2, C5.2, C6.2, C7.2, C8.2, C9.1, C10.1, J1.5 (GND), J1.SH (Shield), J2.6, R1.2, SW1.1, U1.8 (VSSA), U1.23 (VSS), U1.35 (VSS), U1.47 (VSS), Y1.2 (G), Y1.4 (G); also elsewhere on the board
unnamed: R2.1, U1.25 (PB12)

Notes on the sheet:
VDDA - C7, 8
JTAG
VDD3 - C2, 3
VBAT - C6
VDD1 - C5
VDD2 - C4
Oscilator
USB Mini B
Debugger

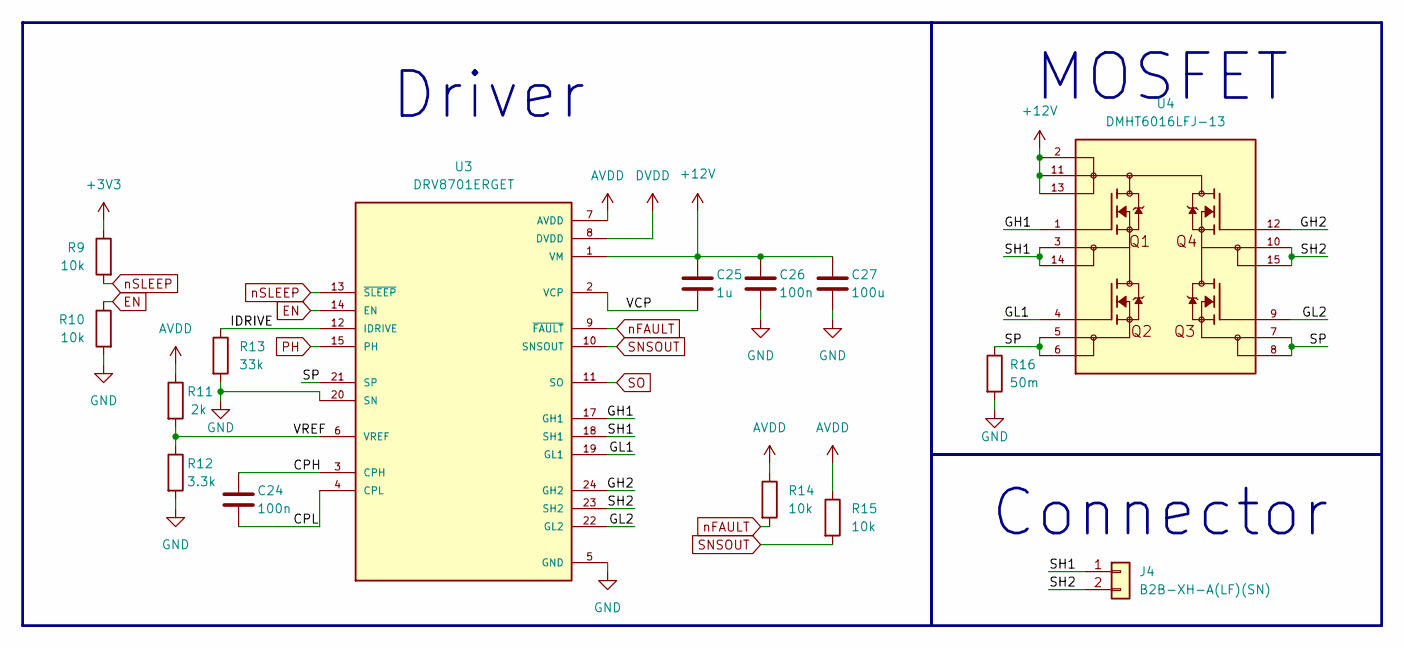
[picture p10: schematic motor_driver_5.kicad_sch]

Parts:
C24, C26: 100n; C_0805_2012Metric_Pad1.18x1.45mm_HandSolder
C25: 1u; C_0805_2012Metric_Pad1.18x1.45mm_HandSolder
C27: 100u; C_1210_3225Metric_Pad1.33x2.70mm_HandSolder
J4: B2B-XH-A(LF)(SN); JST_XH_B2B-XH-A_1x02_P2.50mm_Vertical
R9, R10, R14, R15: 10k; R_0805_2012Metric_Pad1.20x1.40mm_HandSolder
R11: 2k; R_0805_2012Metric_Pad1.20x1.40mm_HandSolder
R12: 3.3k; R_0805_2012Metric_Pad1.20x1.40mm_HandSolder
R13: 33k; R_0805_2012Metric_Pad1.20x1.40mm_HandSolder
R16: 50m; R_0805_2012Metric_Pad1.20x1.40mm_HandSolder
U3: DRV8701ERGET; QFN-24-1EP_4x4mm_P0.5mm_EP2.7x2.7mm; PARTREV B
U4: DMHT6016LFJ-13; V-DFN5045-12; PARTREV 2-2

Connections:
+3V3: R9.1; also elsewhere on the board
+12V: C25.1, C26.1, C27.1, U3.1 (VM), U4.2, U4.11, U4.13; also elsewhere on the board
/[5] - Motor Driver/CPH: C24.1, U3.3 (CPH)
/[5] - Motor Driver/CPL: C24.2, U3.4 (CPL)
/[5] - Motor Driver/GH1: U3.17 (GH1), U4.1
/[5] - Motor Driver/GH2: U3.24 (GH2), U4.12
/[5] - Motor Driver/GL1: U3.19 (GL1), U4.4
/[5] - Motor Driver/GL2: U3.22 (GL2), U4.9
/[5] - Motor Driver/IDRIVE: R13.1, U3.12 (IDRIVE)
/[5] - Motor Driver/SH1: J4.1, U3.18 (SH1), U4.3, U4.14
/[5] - Motor Driver/SH2: J4.2, U3.23 (SH2), U4.10, U4.15
/[5] - Motor Driver/SP: R16.1, U3.21 (SP), U4.5, U4.6, U4.7, U4.8
/[5] - Motor Driver/VCP: C25.2, U3.2 (VCP)
/[5] - Motor Driver/VREF: R11.2, R12.1, U3.6 (VREF)
AVDD: R11.1, R14.1, R15.1, U3.7 (AVDD)
DVDD: U3.8 (DVDD)
EN: R10.1, U3.14 (EN); also elsewhere on the board
GND: C26.2, C27.2, R10.2, R12.2, R13.2, R16.2, U3.5 (GND), U3.16 (GND), U3.20 (SN), U3.25 (GND); also elsewhere on the board
PH: U3.15 (PH); also elsewhere on the board
SNSOUT: R15.2, U3.10 (SNSOUT); also elsewhere on the board
SO: U3.11 (SO); also elsewhere on the board
nFAULT: R14.2, U3.9 (~FAULT); also elsewhere on the board
nSLEEP: R9.2, U3.13 (~SLEEP)

Notes on the sheet:
Driver
MOSFET
Connector
