Vibhors-Tech-Hub/STM32F407-Dev-Kit/hardware/STM32F407 Dev Kit.kicad_pcb

## KiCad design hardware/STM32F407 Dev Kit.kicad_pcb (continued)

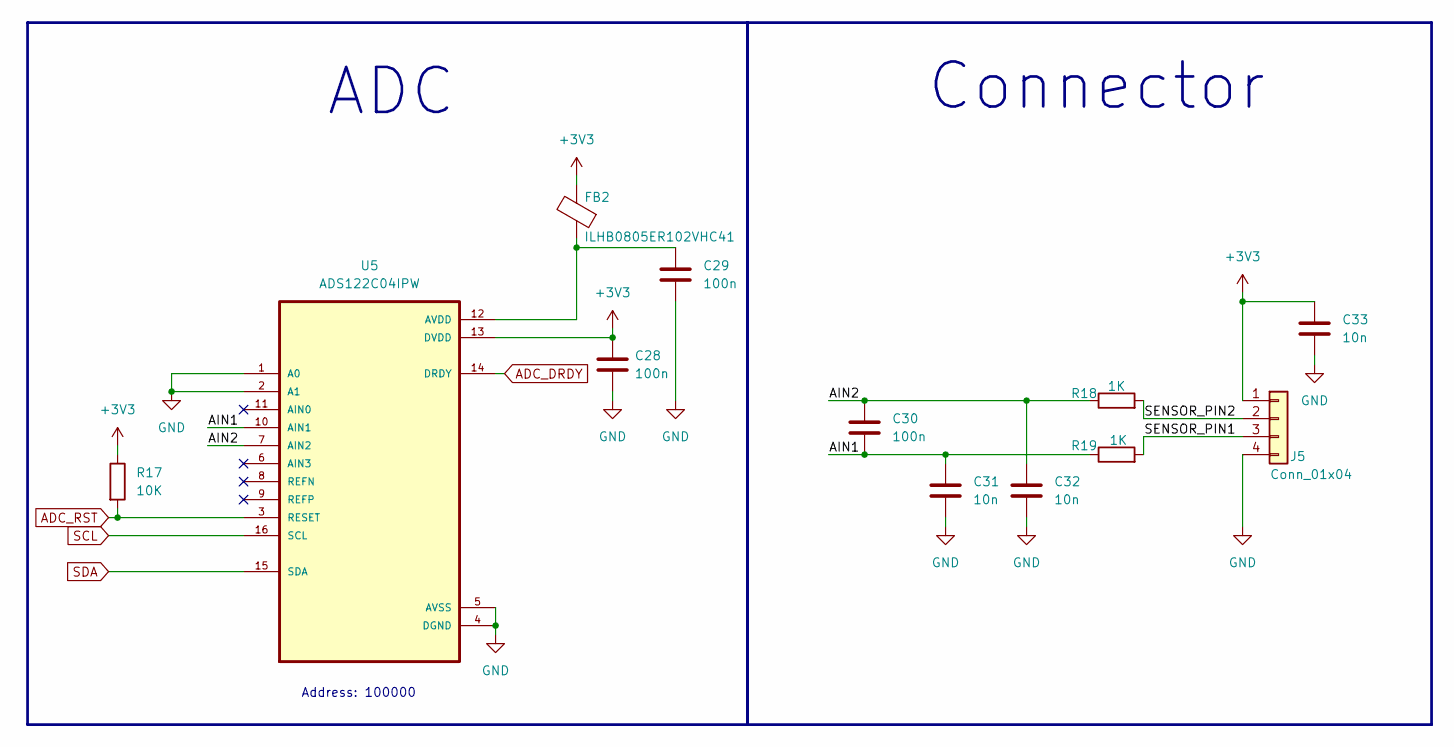
[picture p11: schematic adc_6.kicad_sch]

Parts:
C28, C29, C30: 100n; C_0805_2012Metric_Pad1.18x1.45mm_HandSolder
C31, C32, C33: 10n; C_0805_2012Metric_Pad1.18x1.45mm_HandSolder
FB2: ILHB0805ER102VHC41; C_0805_2012Metric_Pad1.18x1.45mm_HandSolder
J5: Conn_01x04; PinHeader_1x04_P2.54mm_Vertical
R17: 10K; R_0805_2012Metric_Pad1.20x1.40mm_HandSolder
R18, R19: 1K; R_0805_2012Metric_Pad1.20x1.40mm_HandSolder
U5: ADS122C04IPW; TSSOP-16_4.4x5mm_P0.65mm

Connections:
+3V3: C28.1, C33.1, FB2.2, J5.1, R17.1, U5.13 (DVDD); also elsewhere on the board
/[6] - ADC/AIN1: C30.2, C31.1, R19.1, U5.10 (AIN1)
/[6] - ADC/AIN2: C30.1, C32.1, R18.1, U5.7 (AIN2)
/[6] - ADC/SENSOR_PIN1: J5.3, R19.2
/[6] - ADC/SENSOR_PIN2: J5.2, R18.2
ADC_DRDY: U5.14 (DRDY); also elsewhere on the board
ADC_RST: R17.2, U5.3 (RESET); also elsewhere on the board
GND: C28.2, C29.2, C31.2, C32.2, C33.2, J5.4, U5.1 (A0), U5.2 (A1), U5.4 (DGND), U5.5 (AVSS); also elsewhere on the board
unnamed: C29.1, FB2.1, U5.12 (AVDD)
SCL: U5.16 (SCL); also elsewhere on the board
SDA: U5.15 (SDA); also elsewhere on the board

Notes on the sheet:
ADC
Address: 100000
Connector

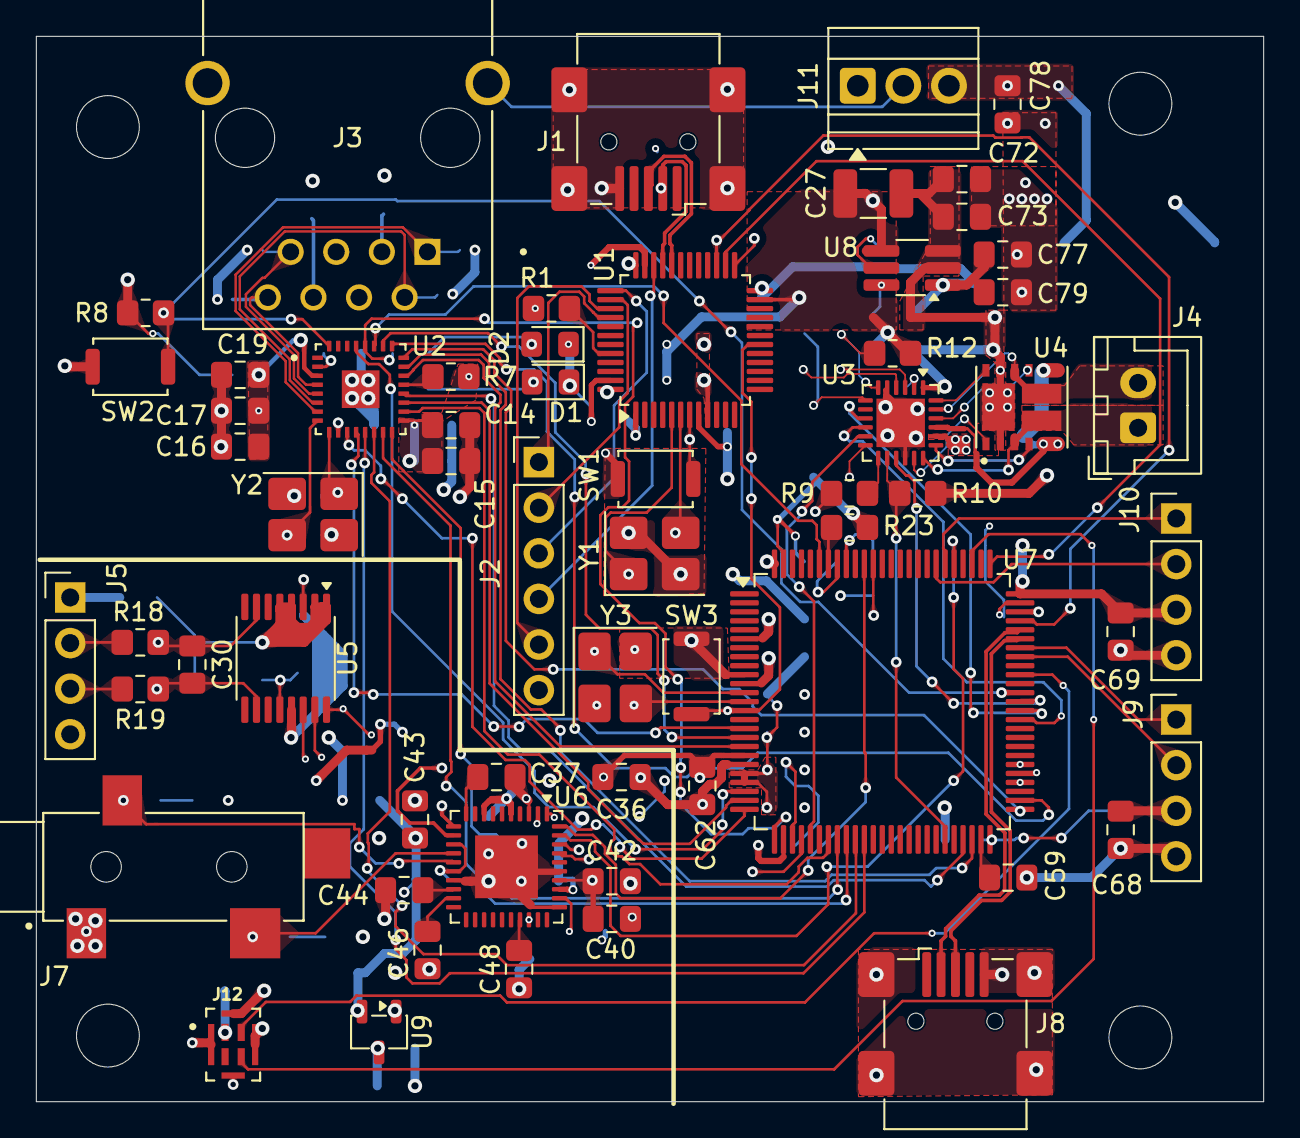
[picture p12: board STM32F407 Dev Kit.kicad_pcb from above]

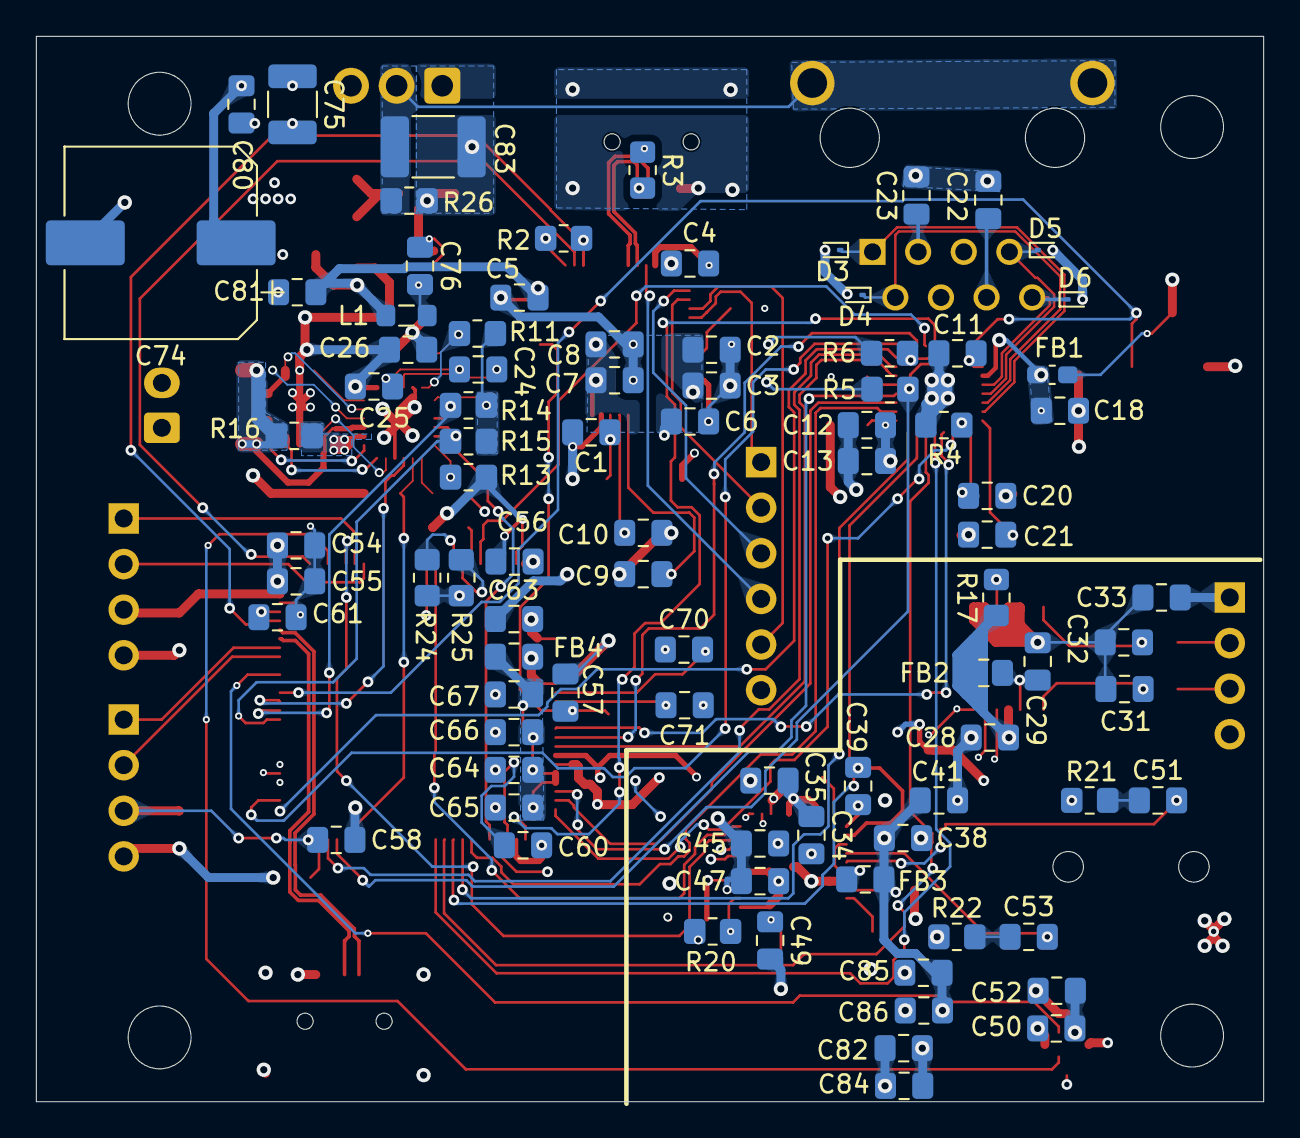
[picture p13: board STM32F407 Dev Kit.kicad_pcb from below]

Board: 4 copper layers, 68.4 x 59.3 mm, 153 parts (88 on the bottom side), 113 nets.
