Vibhors-Tech-Hub/STM32F407-Dev-Kit/(commit log)

2026-10-10 Add Block Diagram and Power Budget
    [STM32F407 Dev Kit.kicad_pcb, STM32F407 Dev Kit.kicad_sch, block_diagram_1.kicad_sch, power_budget_2.kicad_sch]
2026-10-10 Add STM32F103 Debugger
    [stm32f103_debugger_3.kicad_sch]
2026-10-10 Add ETHERNET PHY
    [ethernet_phy_4.kicad_sch]
2026-10-10 Add Motor Driver
    [motor_driver_5.kicad_sch]
2026-10-22 Design schematic for MIC & Headphones
    [STM32F407 Dev Kit.kicad_sch, adc_6.kicad_sch, dac_mic_7.kicad_sch, stm32f103_debugger_3.kicad_sch]
2026-10-22 Design Schematic for STM32F407
    [STM32F407 Dev Kit.kicad_sch, adc_6.kicad_sch, dac_mic_7.kicad_sch, ethernet_phy_4.kicad_sch, stm32f407_8.kicad_sch]
2026-10-23 Complete Schematic for Power Section
    [STM32F407 Dev Kit.kicad_sch, adc_6.kicad_sch, dac_mic_7.kicad_sch, ethernet_phy_4.kicad_sch, motor_driver_5.kicad_sch, power_9.kicad_sch, power_budget_2.kicad_sch, stm32f407_8.kicad_sch]
2026-10-23 Organize schematic
    [STM32F407 Dev Kit.kicad_sch, adc_6.kicad_sch, dac_mic_7.kicad_sch, ethernet_phy_4.kicad_sch, motor_driver_5.kicad_sch, power_9.kicad_sch, power_budget_2.kicad_sch, stm32f103_debugger_3.kicad_sch]
2026-10-24 Link footprints to Symbols
    [adc_6.kicad_sch, dac_mic_7.kicad_sch, ethernet_phy_4.kicad_sch, motor_driver_5.kicad_sch, power_9.kicad_sch, stm32f103_debugger_3.kicad_sch, stm32f407_8.kicad_sch]
2026-10-24 Convert Schematic to PCB
    [STM32F407 Dev Kit.kicad_pcb, adc_6.kicad_sch, dac_mic_7.kicad_sch, ethernet_phy_4.kicad_sch, motor_driver_5.kicad_sch, power_9.kicad_sch, stm32f103_debugger_3.kicad_sch, stm32f407_8.kicad_sch]
2026-10-25 Draw Board Outline
    [STM32F407 Dev Kit.kicad_pcb]
2026-10-27 Place Components for Ethernet
    [STM32F407 Dev Kit.kicad_pcb, ethernet_phy_4.kicad_sch]
2026-10-28 Place components for STM32F103 Programmer/Debugger
    [STM32F407 Dev Kit.kicad_pcb, ethernet_phy_4.kicad_sch, stm32f103_debugger_3.kicad_sch]
2026-10-28 Place components for Power section
    [STM32F407 Dev Kit.kicad_pcb, ethernet_phy_4.kicad_sch, power_9.kicad_sch]
2026-10-28 Place components for Motor Driver
    [STM32F407 Dev Kit.kicad_pcb]
2026-10-28 Place components for STM32F407
    [STM32F407 Dev Kit.kicad_pcb]
2026-10-28 Place components for ADC
    [STM32F407 Dev Kit.kicad_pcb, adc_6.kicad_sch]
2026-10-28 Place components for DAC and Mic
    [STM32F407 Dev Kit.kicad_pcb, dac_mic_7.kicad_sch]
2026-10-28 Review Component Placement
    [STM32F407 Dev Kit.kicad_pcb]
2026-10-29 Route Ethernet section and add global labels
    [STM32F407 Dev Kit.kicad_pcb, adc_6.kicad_sch, dac_mic_7.kicad_sch, ethernet_phy_4.kicad_sch, motor_driver_5.kicad_sch, power_9.kicad_sch, stm32f103_debugger_3.kicad_sch, stm32f407_8.kicad_sch]
2026-10-29 Route STM32F103 debugger section
    [STM32F407 Dev Kit.kicad_pcb]
2026-10-29 Route power section
    [STM32F407 Dev Kit.kicad_pcb]
2026-10-29 Route Motor Driver section
    [STM32F407 Dev Kit.kicad_pcb]
2026-10-29 Route Audio and ADC section
    [STM32F407 Dev Kit.kicad_pcb, stm32f407_8.kicad_sch]
2026-10-29 Route STM32F407 section
    [STM32F407 Dev Kit.kicad_pcb]
2026-10-29 Route Ethernet connections to STM32F407
    [STM32F407 Dev Kit.kicad_pcb]
2026-10-29 Route debugger connections to STM32F407
    [STM32F407 Dev Kit.kicad_pcb]
2026-10-29 Route Motor connections to STM32F407
    [STM32F407 Dev Kit.kicad_pcb]
2026-10-30 Fix DRC errors
    [STM32F407 Dev Kit.kicad_pcb, stm32f407_8.kicad_sch]
2026-10-30 Add teardrops
    [STM32F407 Dev Kit.kicad_pcb]
2026-10-30 Gnerate productions files and .step model
    [BOM.csv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]
2026-11-01 Fix typo for C4
    [STM32F407 Dev Kit.kicad_pcb, stm32f103_debugger_3.kicad_sch]
2026-11-01 Fix capacitor footprints
    [STM32F407 Dev Kit.kicad_pcb, motor_driver_5.kicad_sch, power_9.kicad_sch]
2026-11-01 Add prices to BOM
    [BOM.csv, ethernet_phy_4.kicad_sch, power_9.kicad_sch]
